msemtd/robotub/(commit log)

2021-03-27 Now working on PlatformIO with d1_mini board
2021-04-08 Add webserver with live chart of temperature. Get NTP time
2021-05-05 Add second temperature sensor and make everything fit on D1 mini
2021-05-30 add favicon, move script to head, fix chart size in container div
    [main.cpp]
